mizzan-microtonal-piano/hoatzin/board/Docs/Schematic/hoatzin.pdf

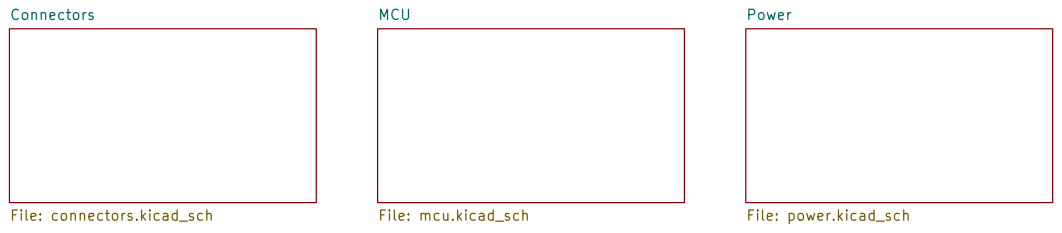
[picture p2: page 1]

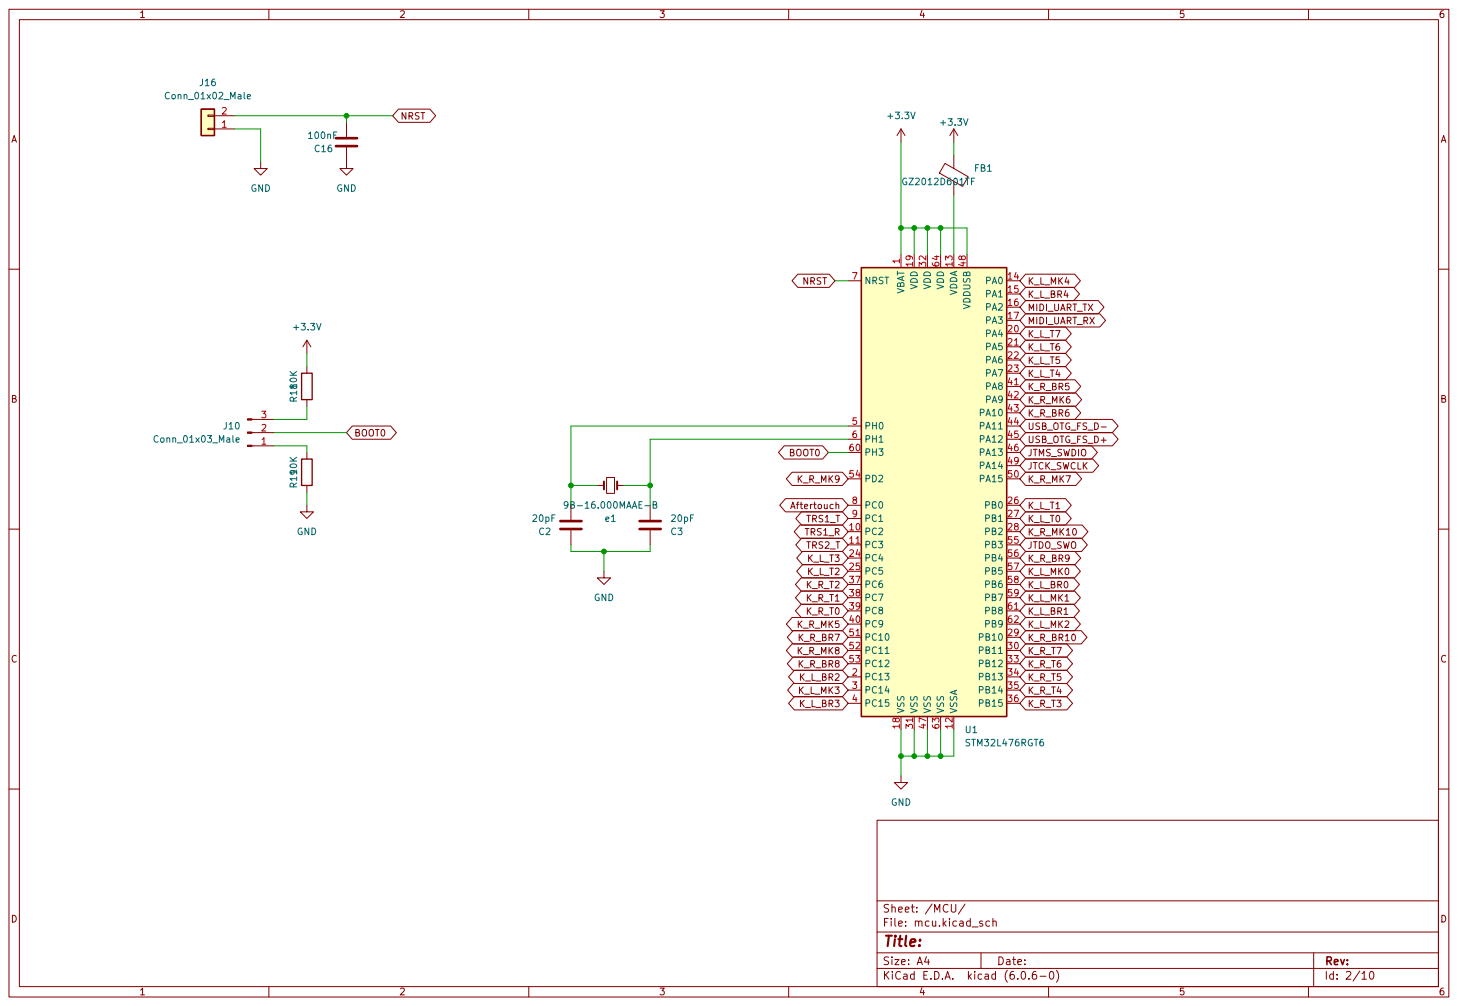
[picture p3: page 2]

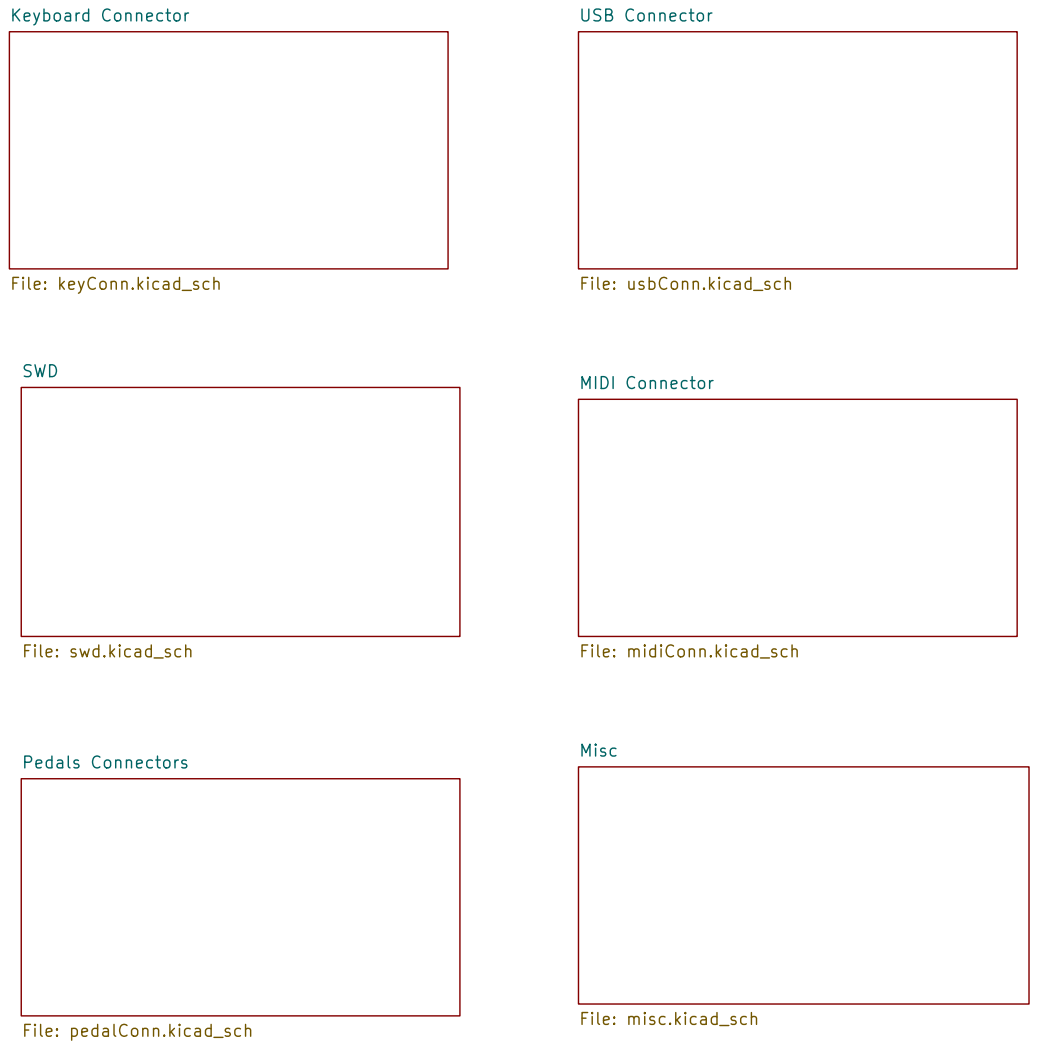
[picture p4: page 3]

File: connectors.kicad_sch Sheet: /Connectors/
Id: 3/10 Title:

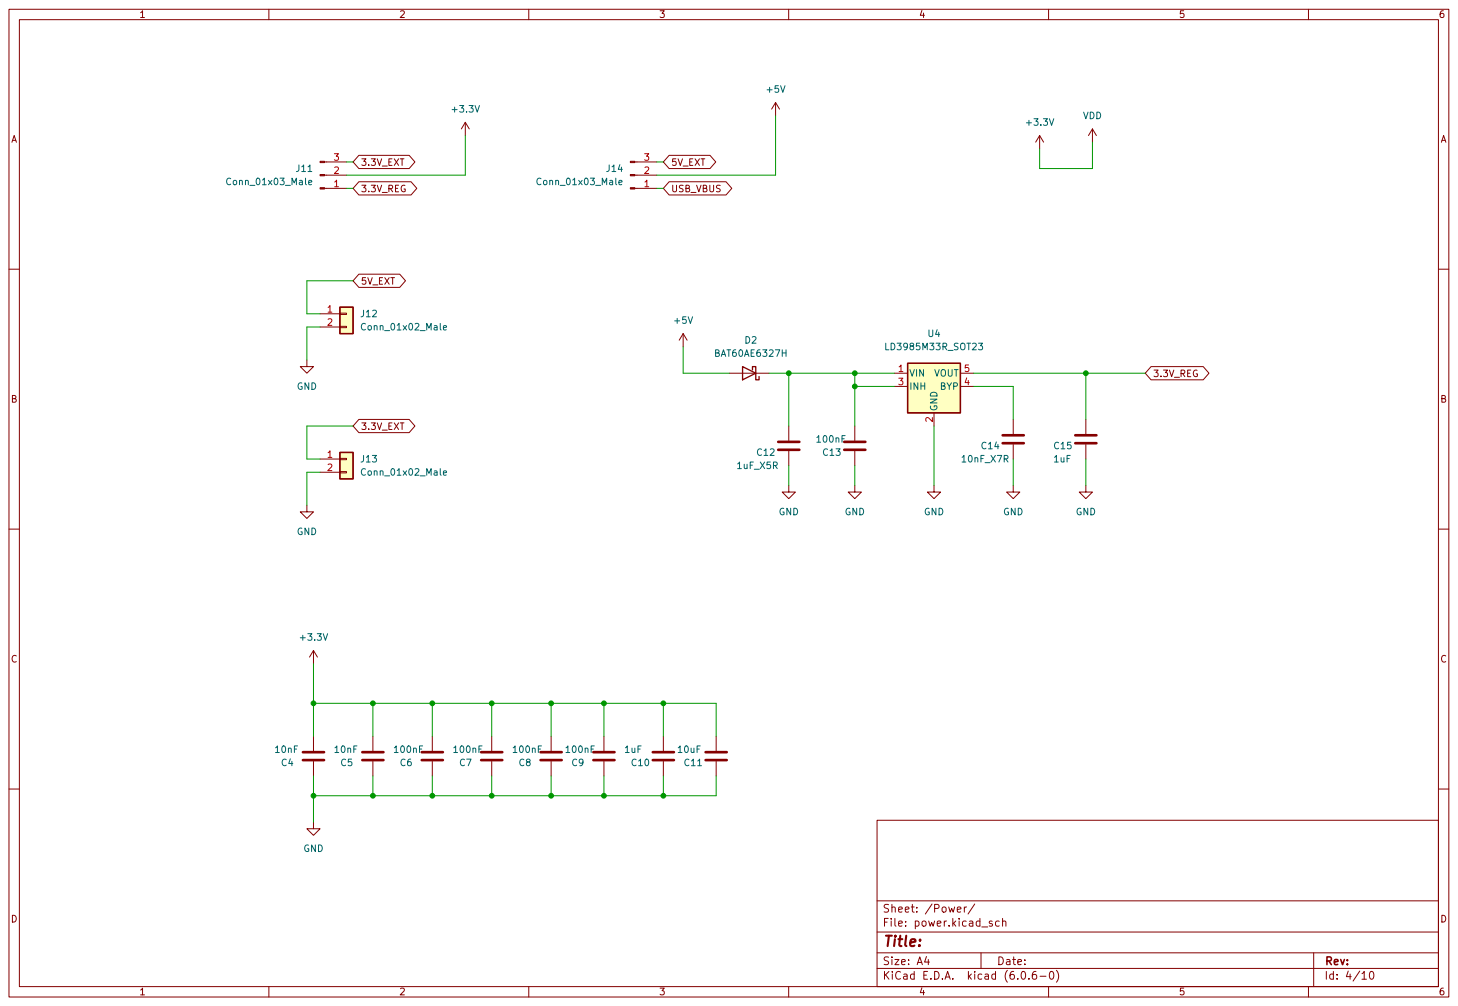
[picture p5: page 4]

File: power.kicad_sch Sheet: /Power/
Id: 4/10 Title:

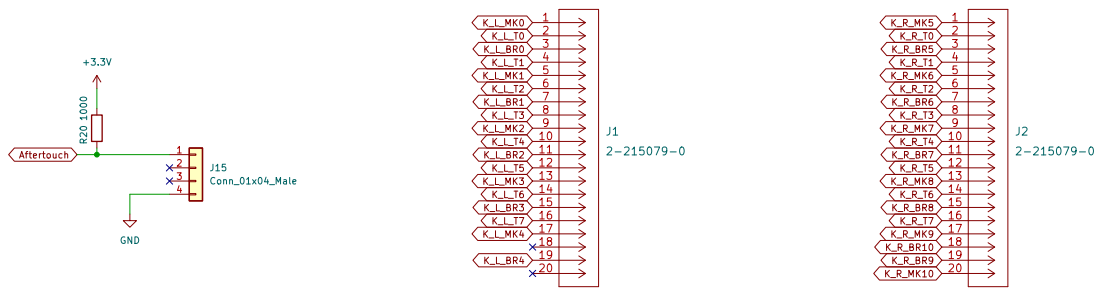
[picture p6: page 5]

Sheet: /Connectors/Keyboard Connector/ R20 1000 +3.3V GND

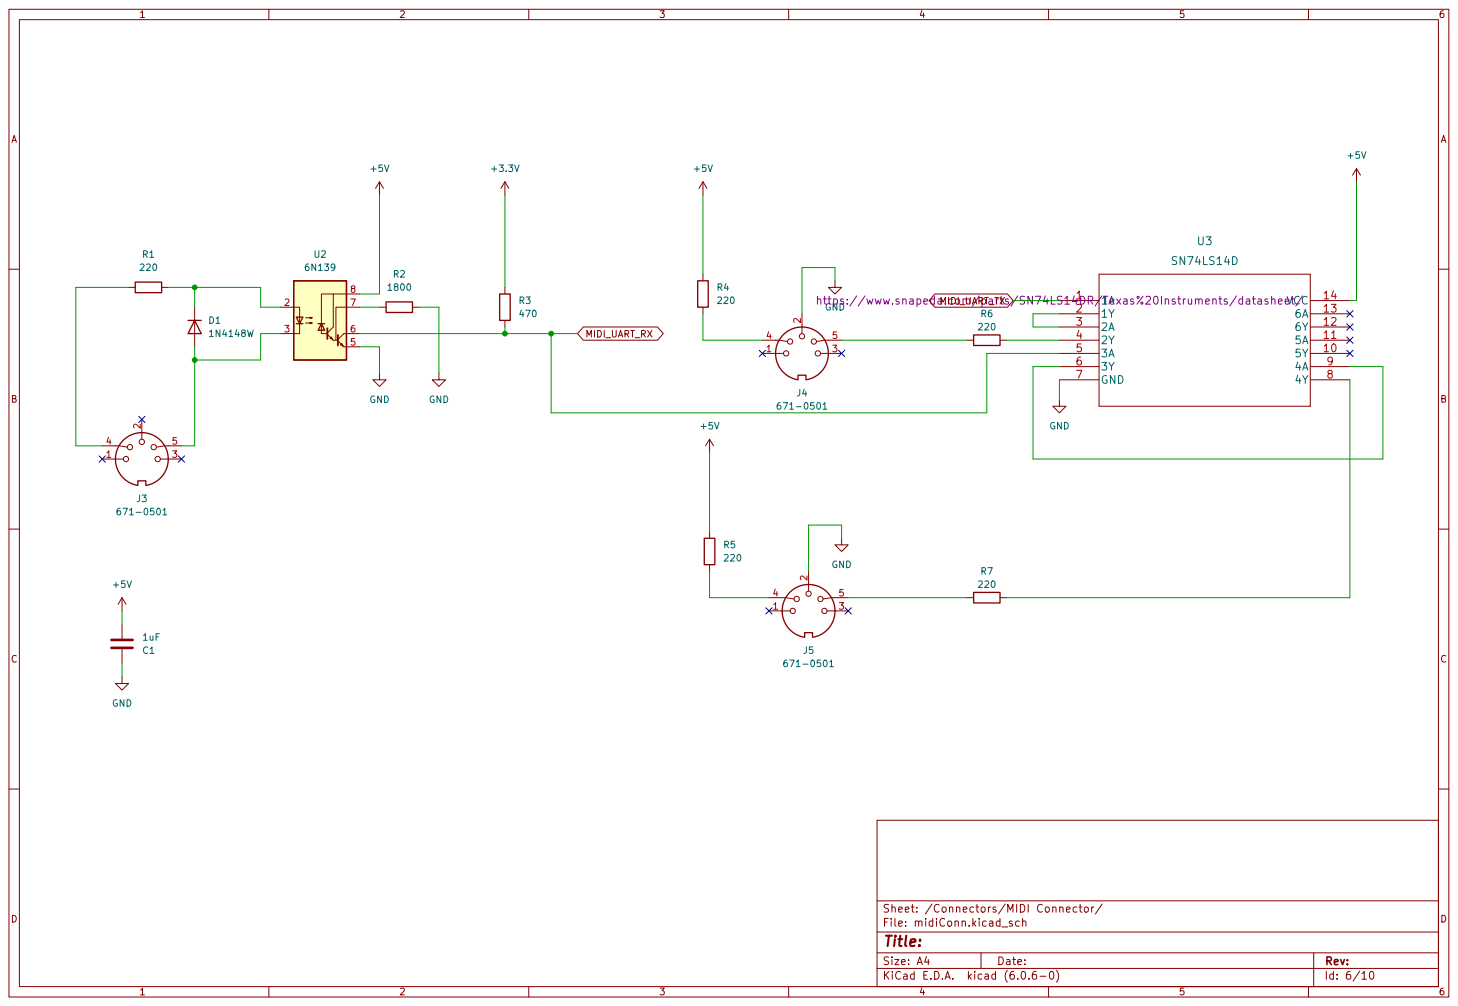
[picture p7: page 6]

https://www.snapeda.com/parts/SN74LS14DR/Texas%20Instruments/datasheet/ R2

File: midiConn.kicad_sch Sheet: /Connectors/MIDI Connector/
Id: 6/10 Title:

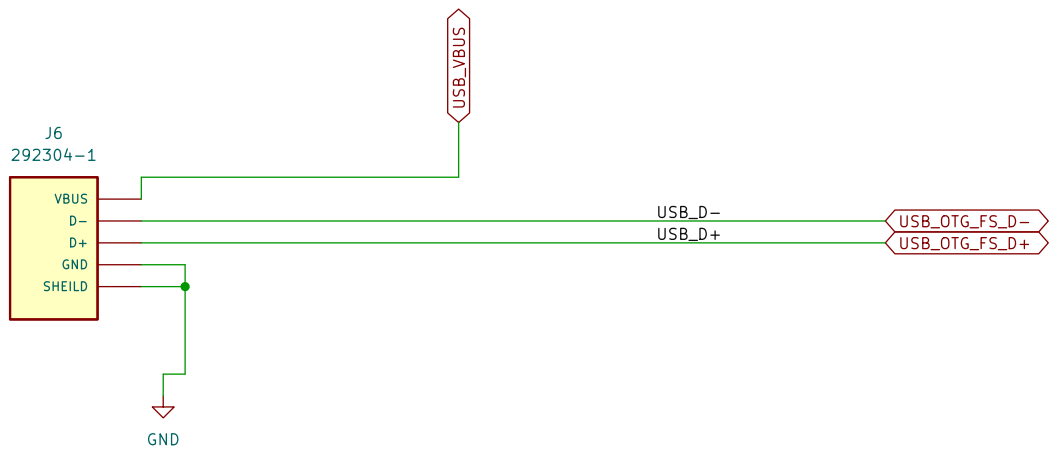
[picture p8: page 7]

File: usbConn.kicad_sch Sheet: /Connectors/USB Connector/ GND

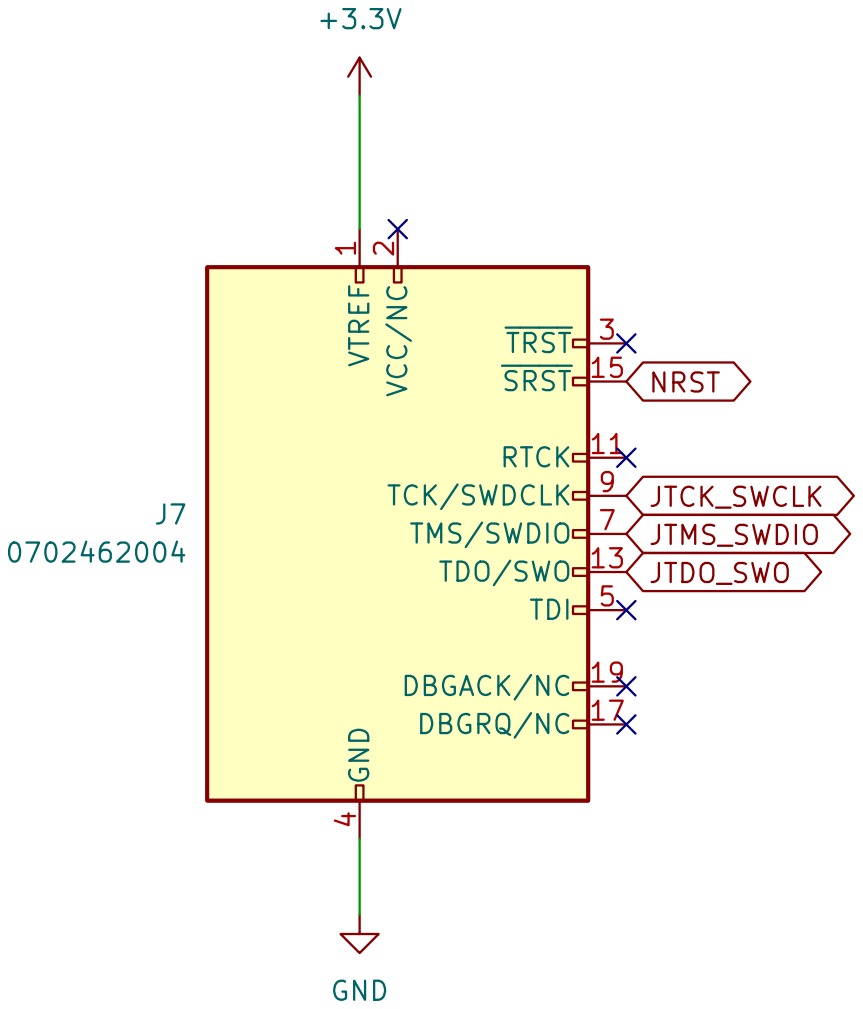
[picture p9: page 8]

1 RTCK 11 TDO/SWO 13 ~{SRST} 15 DBGRQ/NC 17 DBGACK/NC 19 VCC/NC

4 TDI 5 TMS/SWDIO 7 TCK/SWDCLK 9

File: swd.kicad_sch Sheet: /Connectors/SWD/
Id: 8/10 Title:

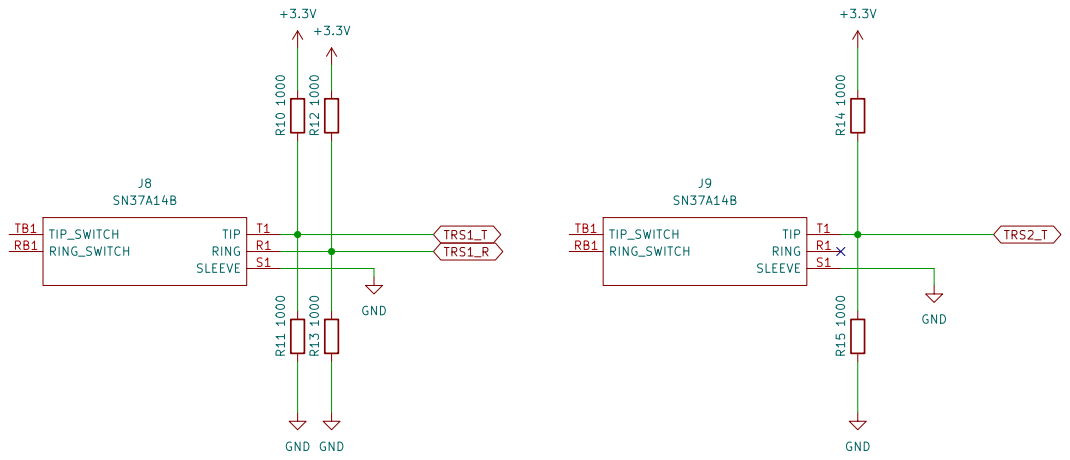
[picture p10: page 9]

File: pedalConn.kicad_sch Sheet: /Connectors/Pedals Connectors/ GND GND

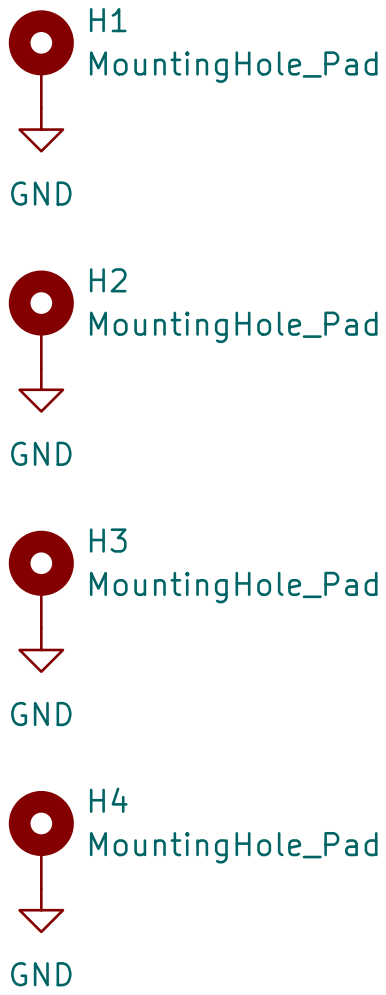
[picture p11: page 10]

File: misc.kicad_sch Sheet: /Connectors/Misc/ H4MountingHole_Pad H3MountingHole_Pad GND GND GND
