mizzan-microtonal-piano/hoatzin/board/Docs/Footprint/hoatzin-B_Cu.pdf

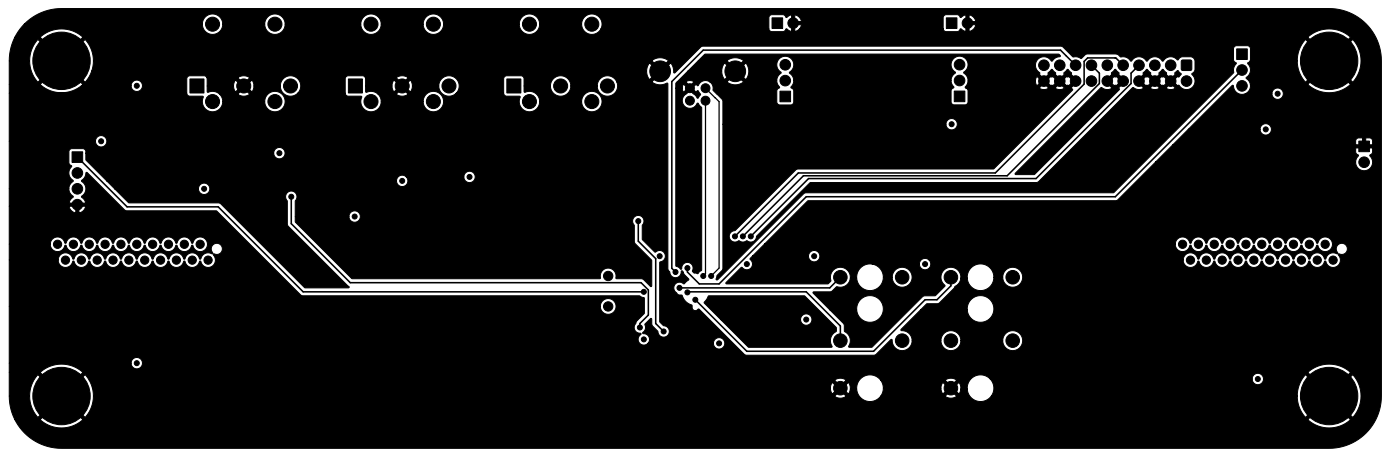
[picture p12: page 1]
