mizzan-microtonal-piano/hoatzin/board/Docs/Footprint/hoatzin-B_Mask.pdf

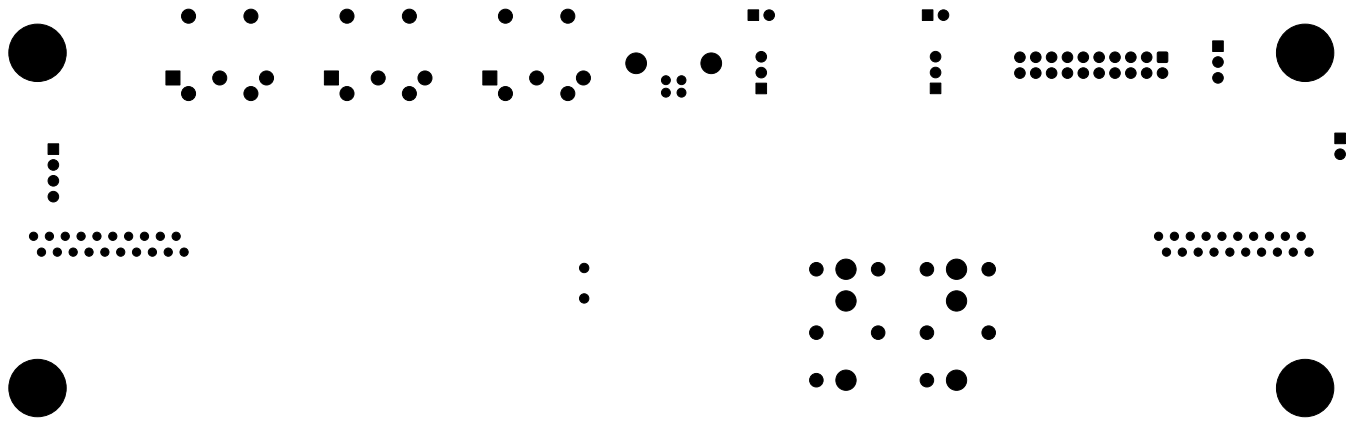
[picture p13: page 1]
