mizzan-microtonal-piano/hoatzin/board/Docs/Footprint/hoatzin-B_Silkscreen.pdf

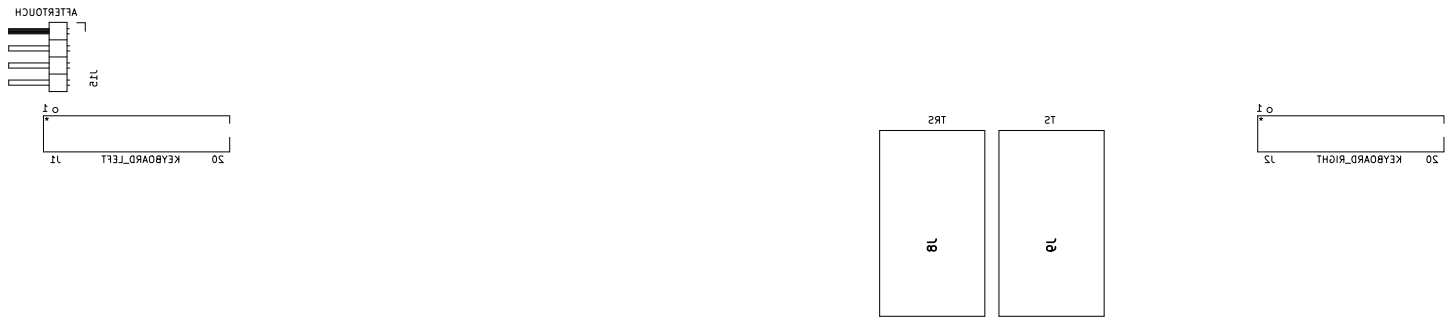
[picture p14: page 1]
