mizzan-microtonal-piano/hoatzin/board/Docs/Footprint/hoatzin-Edge_Cuts.pdf

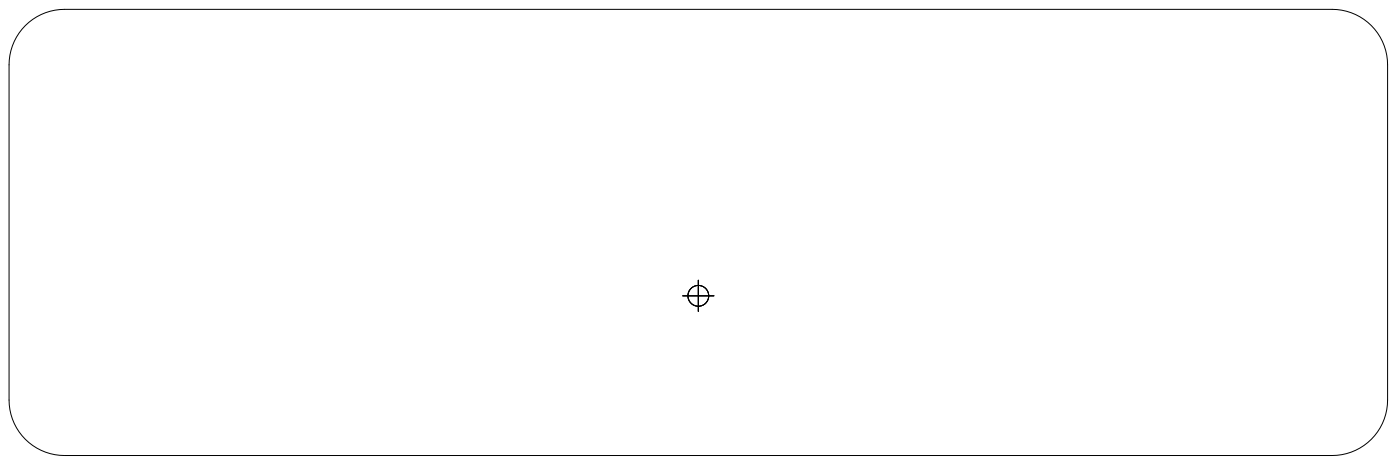
[picture p15: page 1]
