mizzan-microtonal-piano/hoatzin/board/Docs/Footprint/hoatzin-F_Cu.pdf

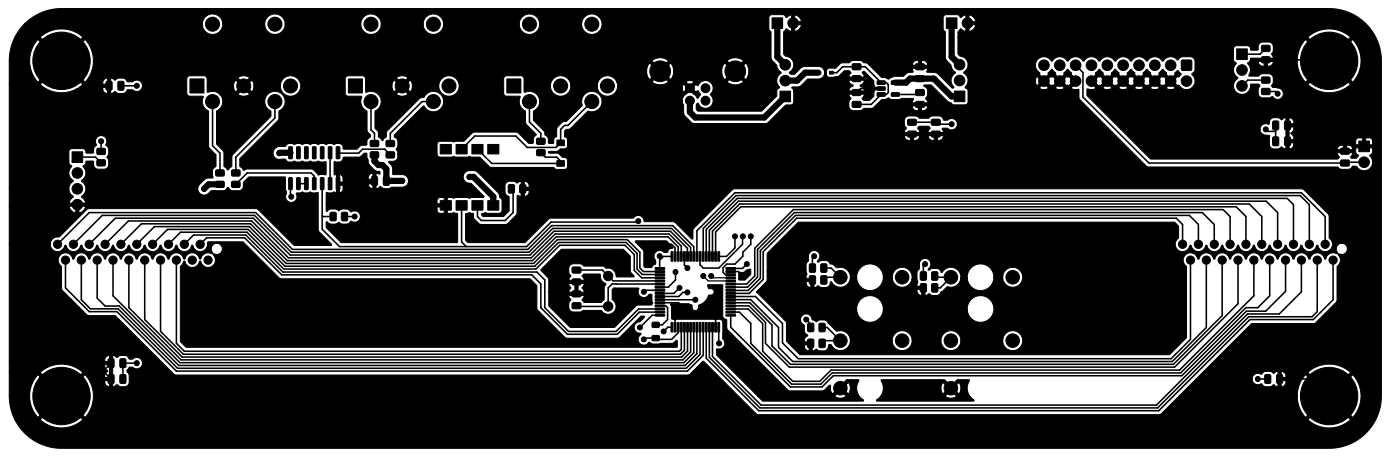
[picture p16: page 1]
