mizzan-microtonal-piano/hoatzin/board/Docs/Footprint/hoatzin-F_Mask.pdf

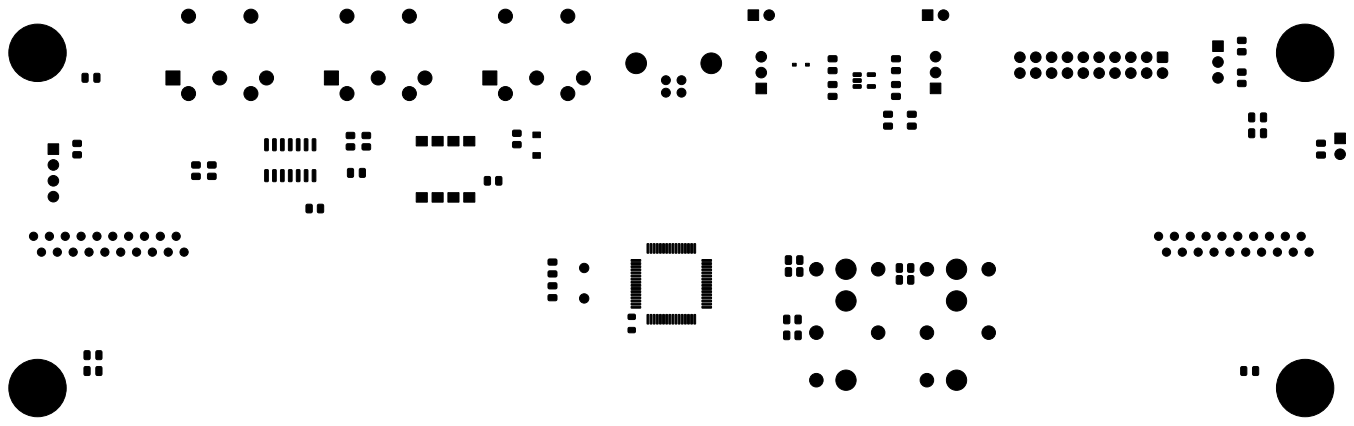
[picture p17: page 1]
