mizzan-microtonal-piano/hoatzin/board/Docs/Footprint/hoatzin-F_Paste.pdf

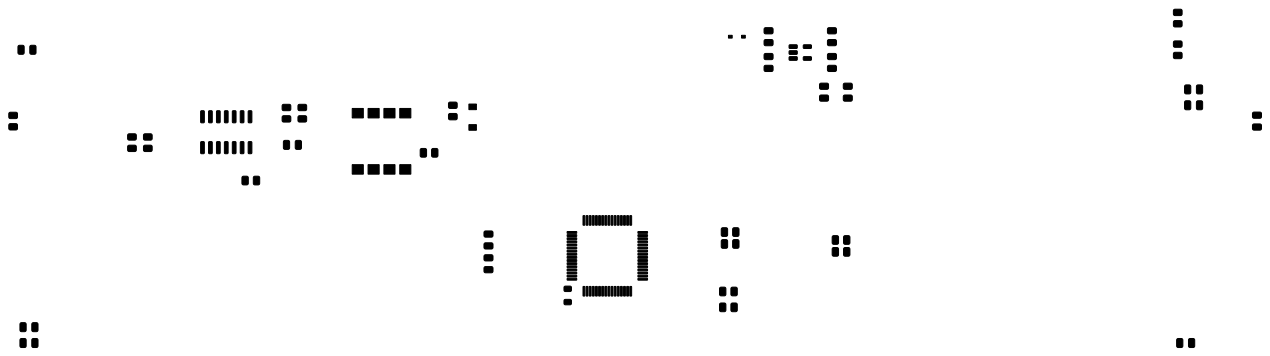
[picture p18: page 1]
