mizzan-microtonal-piano/hoatzin/board/Docs/Footprint/hoatzin-F_Silkscreen.pdf

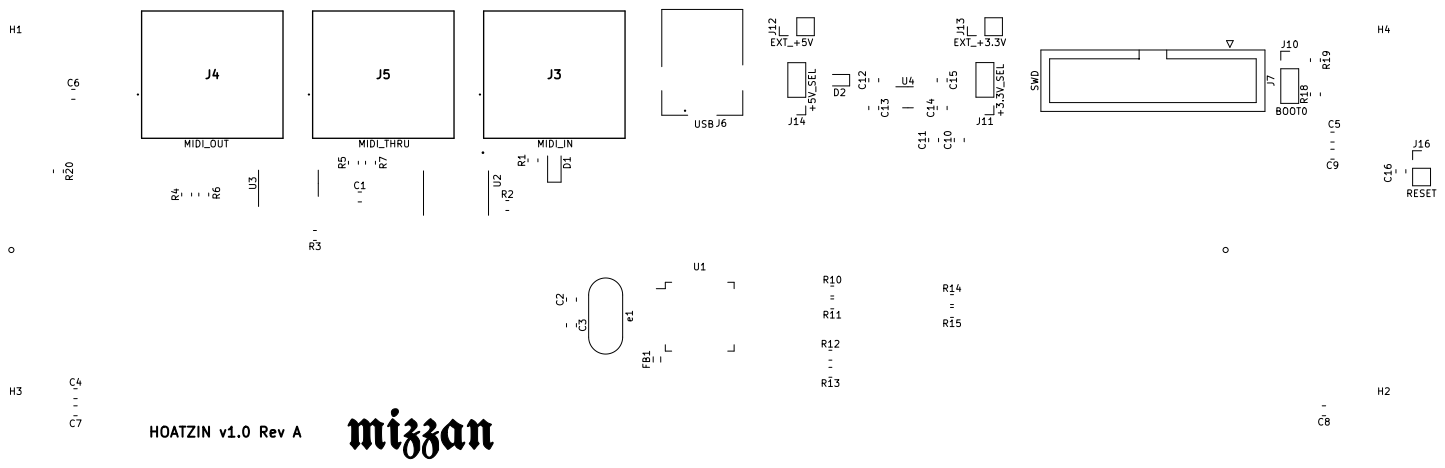
[picture p19: page 1]
