mizzan-microtonal-piano/hoatzin/board/Docs/Footprint/hoatzin-In1_Cu.pdf

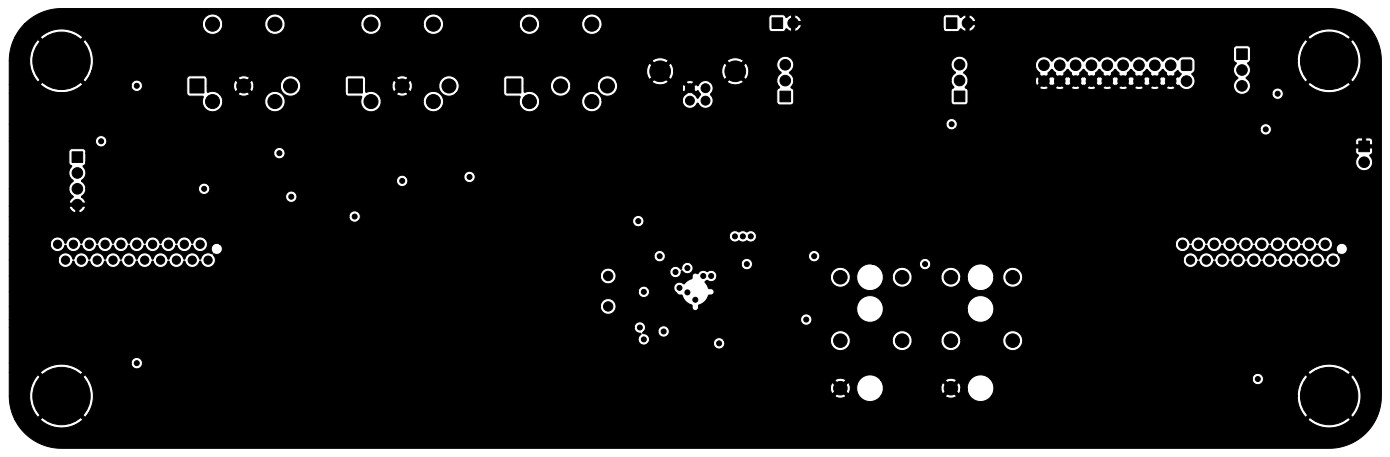
[picture p20: page 1]
