mizzan-microtonal-piano/hoatzin/board/Docs/Footprint/hoatzin-In2_Cu.pdf

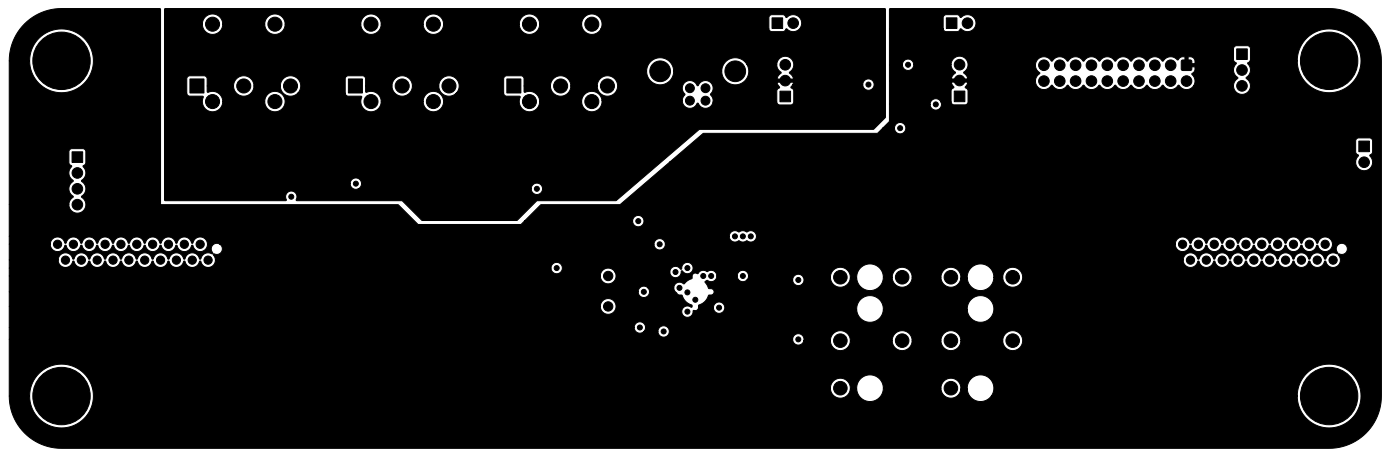
[picture p21: page 1]
