mizzan-microtonal-piano/hoatzin/software/workspace/hoatzin/MIDI/inc/midi_typedef.h

/*
 * midi_typedef.h
 *
 *  Created on: Jun 23, 2022
 *      Author: habiburrahman
 */

#ifndef MIDI_INC_MIDI_TYPEDEF_H_
#define MIDI_INC_MIDI_TYPEDEF_H_



typedef enum {
	NOTE_OFF = 0x80,
	NOTE_ON = 0x90,
	POLY_AFTERTOUCH = 0xA0,
	MODE_CHANGE = 0xB0,
	PROGRAM_CHANGE = 0xC0,
	AFTERTOUCH = 0xD0,
	PITCHBEND_CHANGE = 0xE0,
}MIDI_CHANNEL_VOICE_MESSAGE_t;


typedef enum {
	CHANNEL_1 = 0x00,
	CHANNEL_2 = 0x01,
	CHANNEL_3 = 0x02,
	CHANNEL_4 = 0x03,
	CHANNEL_5 = 0x04,
	CHANNEL_6 = 0x05,
	CHANNEL_7 = 0x06,
	CHANNEL_8 = 0x07,
	CHANNEL_9 = 0x08,
	CHANNEL_10 = 0x09,
	CHANNEL_11 = 0x0A,
	CHANNEL_12 = 0x0B,
	CHANNEL_13 = 0x0C,
	CHANNEL_14 = 0x0D,
	CHANNEL_15 = 0x0E,
	CHANNEL_16 = 0x0F,
}MIDI_CHANNEL_t;


typedef enum {

	SYSTEM_EXCLUSIVE = 0xF0,
	MIDI_TIME_CODE_QUARTER_FRAME = 0xF1,
	SONG_POSITION_POINTER = 0xF2,
	SONG_SELECT = 0xF3,
	TUNE_REQUEST = 0xF6,
	EOX = 0xF7,
	TIMING_CLOCK = 0xF8,
	START = 0xFA,
	CONTINUE = 0xFB,
	STOP =  0xFC,
	ACTIVE_SENSING = 0xFE,
	SYSTEM_RESET = 0xFF,
}MIDI_CHANNEL_MODE_MESSAGE_t;




typedef enum{
	BANK_SELECT_MSB = 0x00,
	MODULATION_WHEEL_MSB = 0x01,
	BREATH_CONTROLLER_MSB = 0x02,
	FOOT_CONTROLLER_MSB = 0x04,
	PORTAMENTO_TIME_MSB = 0x05,
	DATA_ENTRY_MSB = 0x06,
	CHANNEL_VOLUME_MSB = 0x07,
	BALANCE_MSB = 0x08,
	PAN_MSB = 0x0A,
	EXPRESSION_CONTROL_MSB = 0x0B,
	EFFECT_CONTROL_1_MSB = 0x0C,
	EFFECT_CONTROL_2_MSB = 0x0D,
	GENERAL_PURPOSE_CONTROLLER_1_MSB = 0x10,
	GENERAL_PURPOSE_CONTROLLER_2_MSB = 0x11,
	GENERAL_PURPOSE_CONTROLLER_3_MSB = 0x12,
	GENERAL_PURPOSE_CONTROLLER_4_MSB = 0x13,
	BANK_SELECT_LSB = 0x20,
	MODULATION_WHEEL_LSB = 0x21,
	BREATH_CONTROLLER_LSB = 0x22,
	FOOT_CONTROLLER_LSB = 0x24,
	PORTAMENTO_TIME_LSB = 0x25,
	DATA_ENTRY_LSB = 0x26,
	CHANNEL_VOLUME_LSB = 0x27,
	BALANCE_LSB = 0x28,
	PAN_LSB = 0x2A,
	EXPRESSION_CONTROL_LSB = 0x2B,
	EFFECT_CONTROL_1_LSB = 0x2C,
	EFFECT_CONTROL_2_LSB = 0x2D,
	GENERAL_PURPOSE_CONTROLLER_1_LSB = 0x30,
	GENERAL_PURPOSE_CONTROLLER_2_LSB = 0x31,
	GENERAL_PURPOSE_CONTROLLER_3_LSB = 0x32,
	GENERAL_PURPOSE_CONTROLLER_4_LSB = 0x33,
	SUSTAIN_ON_OFF = 0x40,
	PORTAMENTO_ON_OFF = 0x41,
	SOSTUNUTO_ON_OFF = 0x42,
	SOFT_PEDAL_ON_OFF = 0x43,
	LEGATO_FOOTSWITCH = 0x44,
	HOLD_2 = 0x45,
	SOUND_CONTROLLER_SOUND_VARIATION = 0x46,
	SOUND_CONTROLLER_TIMBRE   = 0x47,
	SOUND_CONTROLLER_RELEASE_TIME   = 0x48,
	SOUND_CONTROLLER_ATTACK_TIME   = 0x49,
	SOUND_CONTROLLER_BRIGHTNESS   = 0x4A,
	SOUND_CONTROLLER_DECAY_TIME   = 0x4B,
	SOUND_CONTROLLER_VIBRATO_RATE   = 0x4C,
	SOUND_CONTROLLER_VIBRATO_DEPTH   = 0x4D,
	SOUND_CONTROLLER_VIBRATO_DELAY  = 0x4E,
	GENERAL_PURPOSE_CONTROLLER_5 = 0x50,
	GENERAL_PURPOSE_CONTROLLER_6 = 0x51,
	GENERAL_PURPOSE_CONTROLLER_7 = 0x52,
	GENERAL_PURPOSE_CONTROLLER_8 = 0x53,
	PORTAMENTO_CONTROL = 0x54,
	HIGH_RESOLUTION_VELOCITY_PREFIX = 0x58,
	EFFECT_1_DEPTH = 0x5B,
	EFFECT_2_DEPTH = 0x5C,
	EFFECT_3_DEPTH = 0x5D,
	EFFECT_4_DEPTH = 0x5E,
	EFFECT_5_DEPTH = 0x5F,
	DATA_INCREMENT = 0x60,
	DATA_DECREMENT = 0x61,
	NRPN_LSB = 0x62,
	NRPN_MSB = 0x63,
	RPN_LSB = 0x64,
	RPN_MSB = 0x65,

	//channel mode functions
	ALL_SOUND_OFF = 0x78,
	RESET_ALL_CONTROLLERS = 0x79,
	LOCAL_CONTROL_ON_OFF = 0x7A,
	ALL_NOTES_OFF = 0x7B,
	OMNI_MODE_OFF = 0x7C,
	OMNI_MODE_ON = 0x7D,
	MONO_MODE_ON = 0x7E,
	POLY_MODE_ON = 0x7F,

}MIDI_CONTROL_FUNCTION_t;






typedef enum{
	PITCH_BEND_SENSITIVITY = 0x0000,
	CHANNEL_FINE_TUNING = 0x0001,
	CHANNEL_COARSE_TUNING = 0x0002,
	TUNING_PROGRAM_CHANGE = 0x0003,
	TUNING_BANK_SELECT = 0x0004,
	MODULATION_DEPTH_RANGE = 0x0005,
	MPE_CONFIGURATION_MESSAGE = 0x0006
}MIDI_REGISTERED_PARAMETER_FUNCTION_t;


typedef enum{
	AZIMUTH_ANGLE = 0x3D00,
	ELEVATION_ANGLE = 0x3D01,
	GAIN = 0x3D02,
	DISTANCE_RATIO = 0x3D03,
	MAXIMUM_DISTANCE = 0x3D04,
	GAIN_AT_MAXIMUM_DISTANCE = 0x3D05,
	REFERENCE_DISTANCE_RATIO = 0x3D06,
	PAN_SPEED_ANGLE = 0x3D07,
	ROLL_ANGLE = 0x3D08,
}MIDI_3D_SOUND_CONTROL_FUNCTION_t;

#endif /* MIDI_INC_MIDI_TYPEDEF_H_ */
