mizzan-microtonal-piano/hoatzin/software/workspace/hoatzin/Fatar/fatar_typedef.h

/*
 * fatar_typedef.h
 *
 *  Created on: Nov 27, 2022
 *      Author: hr193
 */

#ifndef FATAR_TYPEDEF_H_
#define FATAR_TYPEDEF_H_

typedef enum{
	UNPRESSED,
	BROKEN,
	MADE
}FATAR_KEY_STATUS_t;


#endif /* FATAR_TYPEDEF_H_ */
