mizzan-microtonal-piano/hoatzin/software/workspace/hoatzin/Pedals/inc/pedals.h

/*
 * pedals.h
 *
 *  Created on: Dec 19, 2022
 *      Author: hr193
 */

#ifndef PEDALS_H_
#define PEDALS_H_


void initializePedals();
int readSustainPedal();
int readSustenotoPedal();
int readSoftPedal();
void scanPedals();


#endif /* PEDALS_H_ */
