mizzan-microtonal-piano/hoatzin/(commit log)

2022-06-30 added existing project files and folders
    [connectors.kicad_sch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]
2022-07-01 removed deprecated output files
    [hoatzin-B_Cu.gbr, hoatzin-B_Mask.gbr, hoatzin-B_Paste.gbr, hoatzin-B_Silkscreen.gbr, hoatzin-Edge_Cuts.gbr, hoatzin-F_Cu.gbr, hoatzin-F_Mask.gbr, hoatzin-F_Paste.gbr]
2022-07-07 added mizzan silkscreen logo
    [hoatzin.kicad_pcb]
2022-07-07 mizzan logo reference footprint layer changed to f.fab from f.silkscreen
    [hoatzin.kicad_pcb]
2022-07-07 added PDF schematic and footprint under /Docs
    [hoatzin-B_Cu.gbr, hoatzin-B_Mask.gbr, hoatzin-B_Paste.gbr, hoatzin-B_Silkscreen.gbr, hoatzin-Edge_Cuts.gbr, hoatzin-F_Cu.gbr, hoatzin-F_Mask.gbr, hoatzin-F_Paste.gbr]
2022-07-07 updated gerber and 3D model
    [hoatzin-B_Cu.gbr, hoatzin-B_Mask.gbr, hoatzin-B_Paste.gbr, hoatzin-B_Silkscreen.gbr, hoatzin-Edge_Cuts.gbr, hoatzin-F_Cu.gbr, hoatzin-F_Mask.gbr, hoatzin-F_Paste.gbr]
2022-11-27 created firmware project. Tested MIDI communication over MIDI port as well as USB MIDI
    [hoatzin-B_Cu.gbr, hoatzin-B_Mask.gbr, hoatzin-B_Paste.gbr, hoatzin-B_Silkscreen.gbr, hoatzin-Edge_Cuts.gbr, hoatzin-F_Cu.gbr, hoatzin-F_Mask.gbr, hoatzin-F_Paste.gbr]
2023-06-05 fixed key velocity index
    [connectors.kicad_sch, hoatzin Debug.cfg, hoatzin.kicad_pcb, hoatzin.kicad_sch, keyConn.kicad_sch, mcu.kicad_sch, midiConn.kicad_sch, misc.kicad_sch]
2023-06-05 minor cleanup of board project
    [hoatzin-B_Cu.gbr, hoatzin-B_Mask.gbr, hoatzin-B_Paste.gbr, hoatzin-B_Silkscreen.gbr, hoatzin-Edge_Cuts.gbr, hoatzin-F_Cu.gbr, hoatzin-F_Mask.gbr, hoatzin-F_Paste.gbr]
2024-09-05 updated 3D object
    [hoatzin.kicad_pcb]
